amjadmajid/ipRobot/Latex/Thesis/template/frontcover.tex

%%\usepackage[total={210mm,297mm},left=0pt,bottom=0pt,top=0cm,right=0pt,headsep=0pt,head=0pt,showframe]{geometry}

%%\input{preambleL31958}
%%\begin{titlepage}
\begin {textblock*}{210mm}(0mm,0mm)
\noindent

\sffamily
\vspace{.8cm}
\begin{center}
\Large
Delft University of Technology\\
Master's Thesis in \reportMSC\\
\vspace{2cm}
\parbox{170mm}{\bfseries\centering\Huge\reportTitle}\\
\vspace{1cm}
\parbox{170mm}{\bfseries\centering\reportAuthor}

\end{center}
\end{textblock*}

\begin {textblock*}{210mm}[0.0,1.0](0mm,297mm)
\noindent

\hfill\parbox{15.5cm}{

}
\vspace*{4cm}

\noindent
\hspace{1.89cm}
\hfill\parbox{5cm}{
}
\hspace*{2cm}\\

\vspace*{1.5cm}
\noindent

\end{textblock*}

\null\newpage
