amjadmajid/ipRobot/Latex/Thesis/chapters/appendix_a.tex

\chapter{Schematic of the Robot PCB}
\label{app:schematic_robot}

\begin{figure}[h!]
	\centering
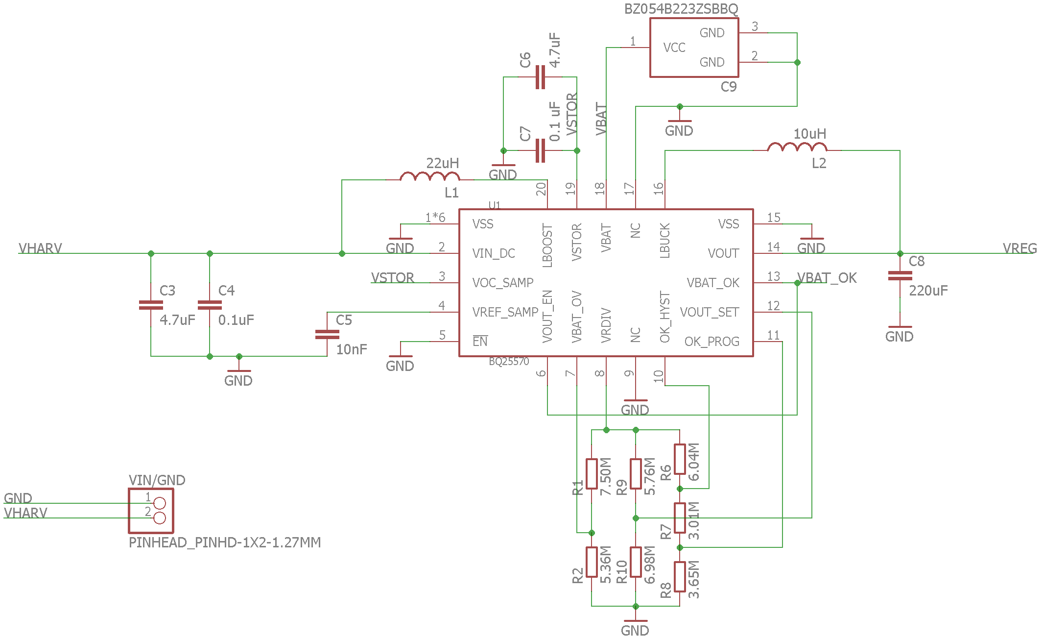
[picture p11: Latex/Thesis/pics/pcb_harvester_schematic.png]
	
	\caption{Energy harvester part of the schematic}
	\label{fig:pcb_harvester_schematic}
\end{figure}

\begin{figure}[h!]
	\centering
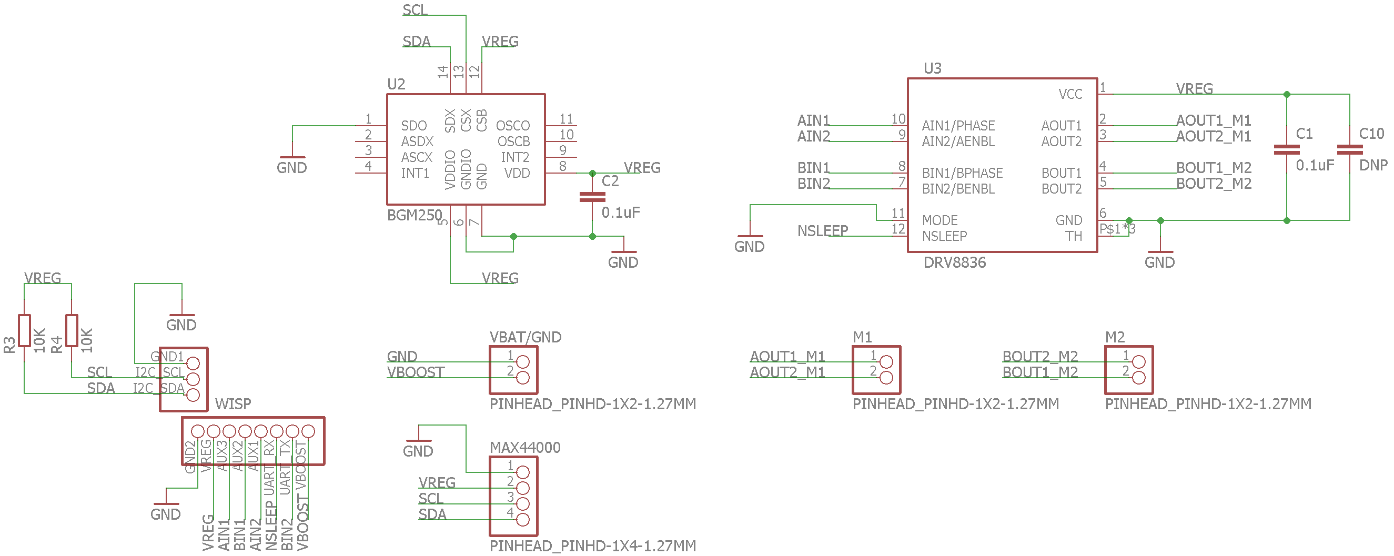
[picture p12: Latex/Thesis/pics/pcb_sens_ctrl_schematic.png]
	
	\caption{Sensing and control part of the schematic}
	\label{fig:pcb_sens_ctrl_schematic}
\end{figure}
