amjadmajid/ipRobot/Latex/Thesis/template/titlepage.tex

\begin{titlepage}

  \begin{center}
  \null\vfill
    \begin{center}
    \LARGE{\reportTitle}
    \end{center}

    \vspace{3cm}

    \begin{large}
    Master's Thesis in \reportMSC
    \end{large}

    \vspace{1.5cm}

    \begin{normalsize}
    Embedded Software Section\\
    Faculty of Electrical Engineering, Mathematics and Computer Science\\
    Delft University of Technology\\
    Mekelweg 4, 2628 CD Delft, The Netherlands
    \end{normalsize}

    \vspace{2.0cm}

    \begin{normalsize}
    \reportAuthor \\
    \reportUrlEmail
    \end{normalsize}

    \vspace{1.0cm}

    % <MM> DD, YYYY
    \reportDate             %TODO: Dit is de datum van uitgifte van final versie aan de afstudeer commissie

  \vfill
  \end{center}

\end{titlepage}
