amjadmajid/ipRobot/Latex/Paper/Ideas-references.txt

Interminttent communication:
https://arxiv.org/pdf/1312.1421v1.pdf

Solar harvesting toy: Solarbotics SolarSpeeder v2.0
https://solarbotics.com/product/k_ss/

Self-driving potato
https://www.youtube.com/watch?v=oNjPHcIzQkM

Braitenberg vehicle

Robotic wireless sensor networks:
https://arxiv.org/pdf/1705.05415.pdf

Intermittend control: 
https://arxiv.org/pdf/1705.08228.pdf

Bio degradeable batteries:
http://www.energyharvestingjournal.com/articles/11125/metal-free-biotically-degradable-battery-for-single-use-applications
http://mems.seas.upenn.edu/publications/2014/AMEMSEnabledBiodegradableBatteryForPoweringTransientImplantableDevices.pdf 

Addressable wireless actuation for multijoint folding robots and devices
http://robotics.sciencemag.org/content/2/8/eaan1544
http://gizmodo.com/incredible-self-folding-robots-work-without-batteries-o-1797125283

Ultra-low-power Wireless Streaming Cameras
https://arxiv.org/pdf/1707.08718.pdf

1D Printing of Recyclable Robots
http://ieeexplore.ieee.org/stamp/stamp.jsp?arnumber=7950924
http://gizmodo.com/this-printer-doodles-stick-figure-robots-to-explore-are-1796985080

Powering Pervasive Computing Systems (already added to bib)
http://ieeexplore.ieee.org/document/7994569/

Combine swarm operating system (links are examples) with intermittent computation
http://ieeexplore.ieee.org/document/7759558/
http://ieeexplore.ieee.org/document/7759660/
