amjadmajid/ipRobot/Latex/Thesis/thesis.tex

% This document provides the style to be used for a MSc Thesis at the
% Parallel and Distributed Systems group
\documentclass[11pt,twoside,a4paper,openright]{report}

% math packages
\usepackage{amsmath}
\usepackage{amssymb}

% textblocks for title page
\usepackage[absolute]{textpos}

% use babel for proper hyphenation
\usepackage[british]{babel}

% Graphics: different for pdflatex or dvi output, choose one
%%\usepackage[dvips]{graphicx}
\usepackage[pdftex]{graphicx}
\usepackage{graphicx}

\usepackage{epstopdf}
\usepackage{rotating}
\usepackage{subcaption}

% FONT
\usepackage[scaled=.92]{helvet}
%\usepackage{times}
\usepackage{textcomp}
\usepackage{eurosym}

% for url's use "\url{http://www.google.com/}"
\usepackage{url}
\usepackage[plainpages=false]{hyperref} 

% Table
\usepackage{threeparttable, tablefootnote}
\usepackage{tabularx}
\usepackage{multirow}

% References
\usepackage{flushend}

% Tikz
\usepackage{tikz}
\usepackage{circuitikz}

% Information that will be filled in at various points in the report
\newcommand{\reportTitle}{Transiently-powered Battery-free Robot}
\newcommand{\reportAuthor}{Koen Schaper}
\newcommand{\reportEmail}{kpschaper@gmail.com}
\newcommand{\reportUrlEmail}{\href{mailto:\reportEmail}{\reportEmail}}
\newcommand{\reportMSC}{Embedded Systems} %{Embedded Systems}{Computer Engineering}{Computer Science}{Electrical Engineering}
\newcommand{\reportDate}{\today} %TODO: Dit is de datum van uitgifte van final versie aan de afstudeer commissie 
\newcommand{\presentationDate}{15 December 2017}
\newcommand{\graduationCommittee}{
prof. dr. K.G. Langendoen (chair) & Delft University of Technology \\
dr. Przemys\l{}aw Pawe\l{}czak (supervisor) & Delft University of Technology \\
dr. Javier Alonso-Mora & Delft University of Technology \\
} % The order of listing the names: Graduation prof, supervisor(s), others ordered by title + alphabetical 
%examples: 
%prof. dr. ir. H. J. Sips (chair) & Delft University of Technology \\ 
%ir. dr. D. H. J. Epema           & Delft University of Technology \\ 
\newcommand{\reportAbstract}{
	\input{chapters/abstract}
}
\newcommand{\reportKeywords}{TODO KEYWORDS}

% For pdflatex
\pdfinfo{
   /Author (\reportAuthor)
   /Title  (\reportTitle)
   /Keywords (\reportKeywords)
}

\begin{document}

\pagenumbering{alph}
\pagestyle{empty}

% FRONTCOVER
\include{template/frontcover}

%%%%%%%%%%%%%%%%%%%%%%%%%%%%%%%%%%%%%%%%%%%%%%%%%%%%%%%%%%%%%%%%%%%%%%%%%%%%%%%
\hoffset=1.63cm
\oddsidemargin=0in
\evensidemargin=0in
\textwidth=5in

%%%%%%%%%%%%%%%%%%%%%%%%%%%%%%%%%%%%%%%%%%%%%%%%%%%%%%%%%%%%%%%%%%%%%%%%%%%%%%%
\parindent=1em

% EMPTY PAGE
\cleardoublepage

\pagestyle{plain}
\pagenumbering{roman}
\setcounter{page}{1}

% TITLE PAGE: page i (hidden)
\include{template/titlepage}

% GRADUATION DATA AND ABSTRACT: pages ii and iii (hidden)
\include{template/graduationdata}
%\setcounter{page}{4}

% EMPTY PAGE: page iv
\cleardoublepage

% OPTIONAL QUOTATION: page v
%\include{quotation}
% EMPTY PAGE: page vi
%\cleardoublepage

% PREFACE: page v
\include{chapters/preface}
% EMPTY PAGE: page vi
\cleardoublepage

% TABLE OF CONTENTS: starting at page vii
\tableofcontents

\cleardoublepage

\pagenumbering{arabic}
\setcounter{page}{1}

% INTRODUCTION: page 1
\include{chapters/introduction}

% CHAPTERS ... For instance: History/Prior Work, Design/Implementation, Experiments
\include{chapters/related_work}

\include{chapters/preliminaries}

%\input{chapters/model}

\include{chapters/design_and_implementation}

\include{chapters/evaluation}

% CONCLUSIONS AND FUTURE WORK
\include{chapters/summary}

% BIBLIOGRAPHY
%#define SORTED 1
%\bibliographystyle{../bib/latex8}
%\bibliography{../bib/bibtex}

\bibliographystyle{IEEEtran}
\bibliography{IEEEabrv,bib/bibtex,bib/non-paper}

\appendix
\include{chapters/appendix_a}

\end{document}
