amjadmajid/ipRobot/Latex/Presentation/pics/foto base/sony_toio.jpg

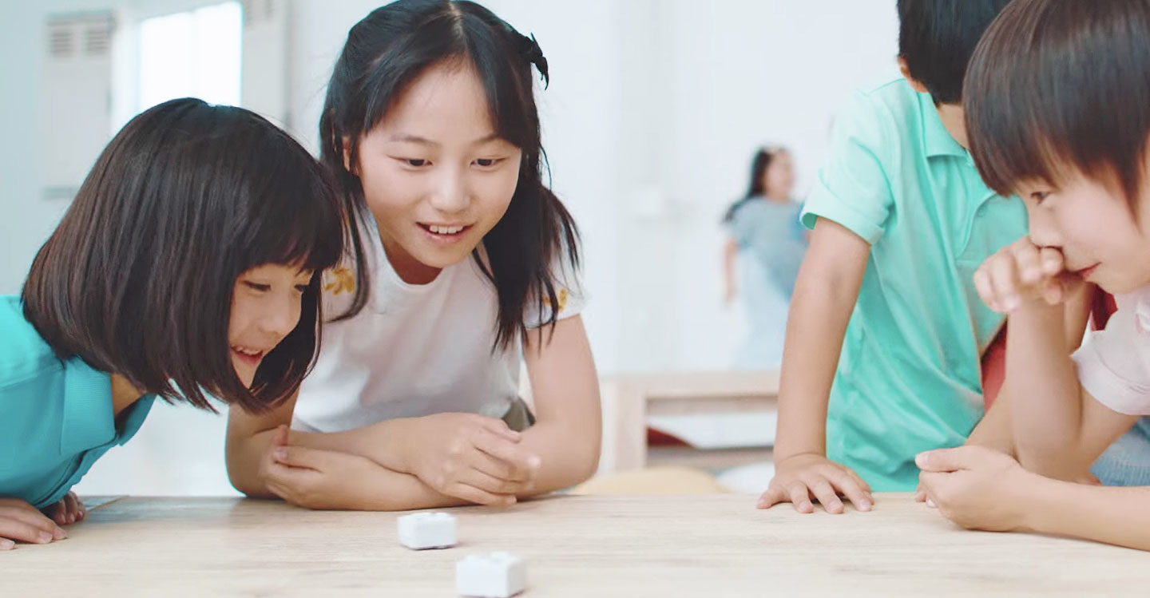
Latex/Presentation/pics/foto base/sony_toio.jpg
