amjadmajid/ipRobot/Latex/Thesis/pics/bipolar_stepper.png

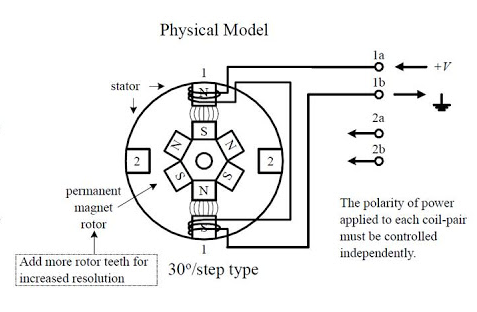
Latex/Thesis/pics/bipolar_stepper.png
