amjadmajid/ipRobot/Latex/Thesis/data/cost_of_parts.xlsx

Sheet: Dollar to euro
Description: | Part name: | Quantity: | cost (dollar): | total cost (dollar): | Cost for 20 (dollar): | Total cost (dollar): | From:
Motors | 26:1 Sub-Micro Plastic Planetary Gearmotor 6Dx16L mm | 2 | 11.95 | 23.9 | 10.76 | 21.52 | Pololu | 18.5072
Wheels | 14×4.5mm Wheel Pair for Sub-Micro Plastic Planetary Gearmotors | 1 | 1.95 | 1.95 | 1.79 | 1.79 | Pololu | 1.5394
Caster | Ball Caster with 1/2″ Plastic Ball | 1 | 1.99 | 1.99 | 1.79 | 1.79 | Pololu | 1.5394
Harvester | BQ25570 | 1 | 7.06 | 7.06 | 6.37 | 6.37 | Digikey | 5.4782
Gyroscope | BMG250 | 1 | 4.19 | 4.19 | 3.27 | 3.27 | Digikey | 2.8122
H-bridge | TI DRV8836 | 1 | 1.91 | 1.91 | 1.72 | 1.72 | Digikey | 1.4792
Supercap | BZ054B223ZSB | 1 | 9.16 | 9.16 | 8.64 | 8.64 | Mouser | 7.4304
PCB | IPR board v2.0 | 1 | 2.166666667 | 2.166666667 | 2.166666667 | 2.166666667 | Osh Park | 1.863333333
Solar panel | SLMD121H04L | 2 | 6.2 | 12.4 | 5.58 | 11.16 | Digikey | 9.5976
Small components | Small components | 1 | 4.406 | 4.406 | 4.406 | 4.406 | Farnell | 3.78916
 |  |  |  | 69.13266667 |  | 62.83266667 |  | 54.03609333
 |  |  |  |  | Euro price: | 54.03609333
Extra sensor:
Proximity sensor | MAX44000 | 1 | 4.22 | 4.22 | 3.98 | 3.98 | Digikey
IR led for proximity | SFH 4651-Z | 1 | 1.11 | 1.11 | 0.86 | 0.86 | Mouser
PCB | Proximity board | 1 | 0.3333333333 | 0.3333333333 | 0.3333333333 | 0.3333333333 | Osh Park
 |  |  |  | 5.663333333 |  | 5.173333333
 |  |  |  |  | Euro price: | 4.5008
 |  |  |  |  | TOTAL EURO PRICE | 58.53689333

Sheet: Euro suppliers
Description: | Part name: | Quantity: | cost: | total cost: | Cost for 20 | Total cost: | From:
Motors | 26:1 Sub-Micro Plastic Planetary Gearmotor 6Dx16L mm | 2 | 10.04 | 20.08 | 9.41 | 18.82 | Tme.eu
Wheels | 14×4.5mm Wheel Pair for Sub-Micro Plastic Planetary Gearmotors | 1 | 2.02 | 2.02 | 1.89 | 1.89 | Tme.eu
Caster | Ball Caster with 1/2″ Plastic Ball | 1 | 1.95 | 1.95 | 1.83 | 1.83 | Tme.eu
Harvester | BQ25570 | 1 | 10.29113924 | 10.29113924 | 5.93 | 5.93 | Farnell
Gyroscope | BMG250 | 1 | 3.848101266 | 3.848101266 | 2.54 | 2.54 | Mouser
H-bridge | TI DRV8836 | 1 | 2.506329114 | 2.506329114 | 1.62 | 1.62 | Farnell
Supercap | BZ054B223ZSB | 1 | 9.82278481 | 9.82278481 | 9.265822785 | 9.265822785 | Mouser
PCB | IPR board v2.0 | 1 | 1.966666667 | 1.966666667 | 1.966666667 | 1.966666667 | Osh Park
Solar panel | SLMD121H04L | 2 | 5.23 | 10.46 | 7.058227848 | 14.1164557 | Digikey
Small components |  | 1 | 4.406 | 4.406 | 4.406 | 4.406 | Farnell
 |  |  |  | 67.3510211 |  | 62.38494515
Extra sensor:
Proximity sensor | MAX44000 | 1 | 4.544303797 | 4.544303797 | 2.54 | 2.54 | Mouser
IR led for proximity | SFH 4651-Z | 1 | 0.85 | 0.85 | 0.66 | 0.85 | Mouser
PCB | Proximity board | 1 | 0.25 | 0.25 | 0.25 | 0.25 | Osh Park
