amjadmajid/ipRobot/Latex/Thesis/pics/step_counting.jpg

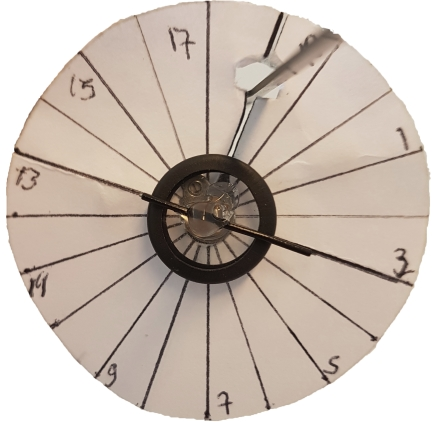
Latex/Thesis/pics/step_counting.jpg
