amjadmajid/ipRobot/Code/Python/Video experiments/PWM_SPEED_RELATION.xlsx

Sheet: Blad1
 |  | Int every 1.25 sec: |  | Int every 1 sec: |  | Int every 0.75 sec |  | Int every 0.5 sec:
 |  | Dist: 143/(145-15) |  | Dist: 143/(142-15) |  | Dist: 143/(135-15) |  | Dist: 143 / (127-15) |  | P control r turn = 0.12
PWM: 70 | Run time: | 5.5 |  | 5.62992126 |  | 5.958333333 |  | 6.383928571
Distance: 150cm max | 5 | 5.5 |  | 5.6 |  | 6 |  | 6.4
141.9 | 28.38 | 144.1 | 26.2 | 141.8 | 25.32142857 | 147.2 | 24.53333333 | 143.5 | 22.421875
146.2 | 29.24 | 145.1 | 26.38181818 | 144.8 | 25.85714286 | 147.3 | 24.55 | 145.1 | 22.671875
144.6 | 28.92 | 144.3 | 26.23636364 | 145.4 | 25.96428571 | 148.1 | 24.68333333 | 147.3 | 23.015625
143.2 | 28.64 | 145.6 | 26.47272727 | 145.3 | 25.94642857 | 146.6 | 24.43333333 | 146.8 | 22.9375
143.1 | 28.62 | 145.9 | 26.52727273 | 143.6 | 25.64285714 | 147.2 | 24.53333333 | 145.2 | 22.6875
 | 28.76 | Avg Speed: | 26.36363636 | Avg Speed: | 25.74642857 | Avg Speed: | 24.54666667 | Avg Speed: | 22.746875
 |  | Int every 1.25 sec: |  | Int every 1 sec: |  | Int every 0.75 sec |  | Int every 0.5 sec:
 |  | Dist: 143/(148-15) |  | Dist: 143/(144-15) |  | Dist: 143/(139-15) |  | Dist: 143 / (129-15)
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
