amjadmajid/ipRobot/Code/Python/Experiments/Light_experiment_11-10_and_23-11.xlsx

Sheet: Chineese panel 50x50
Lamp 60 W halogeen
Distance (cm) | 1 | 2 | 3
50 | 26.04 | 26.71 | 26.08 | 26.27666667 | Light Intensity (Lux) | Temperature
30 | 6.489 | 6.389 | 6.481 | 6.453 | 577 | 22/23
10 | 3.034 | 3.093 | 3.124 | 3.083666667 | 2460 | 23
1 | 1.332 | 1.357 | 1.356 | 1.348333333 | 5790 | 25
 |  |  |  |  | 9550 | 42
Lamp 120 W halogeen
Distance (cm) | 1 | 2 | 3
50 | 17.09 | 18.051 | 17.64 | 17.59366667
30 | 6.703 | 6.766 | 6.694 | 6.721 | 1179 | 23
10 | 1.156 | 2.716 | 2.706 | 2.192666667 | 2496 | 25
 |  |  |  |  | 8760 | 35
Lamp 150W White
Distance (cm) | 1 | 2 | 3
50 | 17.72 | 17.87 | 18.15 | 17.91333333 | Light Intensity (Lux)
30 | 7.846 | 7.795 | 7.843 | 7.828 | 1027 | 26
10 | 1.002 | 0.9503 | 1.029 | 0.9937666667 | 2046 | 25
 |  |  |  |  | 9860 | 37
Lamp 150W Red
Distance (cm) | 1 | 2 | 3
50 | 9.276 | 9.615 | 9.496 | 9.462333333
30 | 1.79 | 1.803 | 2.048 | 1.880333333 | 821 | 31
10 | 0.7548 | 0.7074 | 0.74 | 0.7340666667 | 2652 | 37
 |  |  |  |  | 10550 | 66
Current temp: no light | 22
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
