amjadmajid/ipRobot/Code/Python/Video experiments/settings_deviation_from_straight.xlsx

Sheet: Blad1
30 | avg mean | avg std | max
0 | 0.36 | 0.16 | 0.86
1.25 | 0.34 | 0.12 | 0.67
1 | 0.56 | 0.27 | 1.35
0.75 | 0.6 | 0.27 | 1.04
0.5 | 0.44 | 0.22 | 0.86
Solar | 0.5 | 0.25 | 1.35
50 | avg mean | avg std | max
0 | 0.25 | 0.12 | 0.52
1.25 | 0.31 | 0.14 | 0.72
1 | 0.44 | 0.21 | 0.91
0.75 | 0.8 | 0.35 | 1.44
0.5 | 1.17 | 0.54 | 2.15
Solar | 0.41 | 0.17 | 1.05
70 | avg mean | avg std | max
0 | 0.28 | 0.13 | 0.54
1.25 | 0.42 | 0.17 | 0.9
1 | 0.95 | 0.42 | 1.76
0.75 | 0.88 | 0.37 | 1.88
0.5 | 1.09 | 0.61 | 2.18
Solar | 0.3 | 0.15 | 0.69

Sheet: Length movement
30 | avg mean | avg std | max
0 | 81.6 | 0.17 | 81.78
1.25 | 80.09 | 0.095 | 80.18
1 | 76.41 | 0.22 | 76.63
0.75 | 76.65 | 0.47 | 77.12
0.5 | 76.86 | 1.21 | 78.08
Solar | 80.72 | 0.49 | 81.16
50 | avg mean | avg std | max
0 | 79.62 | 0.47 | 80.09
1.25 | 79.91 | 0.34 | 80.26
1 | 80.35 | 0.17
0.75 | 77.95 | 0.153 | 78.1
0.5 | 79.2 | 0.22 | 79.2
Solar | 80.22 | 1.05 | 81.7
70 | avg mean | avg std | max
0 | 73.72 | 0 | 73.72
1.25 | 73.44 | 0.4 | 73.82
1 | 73.21 | 0.15 | 73.37
0.75 | 74.04 | 0.57 | 74.61
0.5 | 71.3 | 0.02 | 71.35
Solar | 81.4 | 0.38 | 81.92
