amjadmajid/ipRobot/Code/Python/Video experiments/settings_deviation_from_circle.xlsx

30 | R | xoff | yoff | avg mean | avg std | max
0 | 34 | 0 | -7 | 1.3 | 0.67 | 4.3
1.25 | 32 | 0 | -5 | 1.29 | 0.69 | 2.59
1 | 32 | 0 | -3 | 1.52 | 0.81 | 3.95
0.75 | 33 | 0 | -5 | 1.21 | 0.82 | 4.07
0.5 | 32 | 0 | -3 | 1.85 | 1.3 | 6.08
Solar | 32 | -1 | -4 | 0.89 | 0.46 | 1.93
50 | R | xoff | yoff | avg mean | avg std | max
0 | 34 | -1 | -7 | 1.2 | 0.67 | 3.03
1.25 | 32 | 0 | -2 | 1.01 | 0.57 | 2.64
1 | 33 | 0 | -4 | 1.42 | 0.92 | 4.2
0.75 | 33 | 0 | -4 | 1.11 | 0.73 | 2.89
0.5 | 33 | 0 | -4 | 0.79 | 0.37 | 1.86
Solar | 31 | -1 | -3 | 0.88 | 0.4 | 1.91
70 | R | xoff | yoff | avg mean | avg std | max
0 | 30 | 0 | -3 | 0.9 | 0.45 | 2.37
1.25 | 31 | 0 | -2 | 0.81 | 0.43 | 2.99
1 | 31 | 0 | -2 | 1.06 | 0.65 | 3.5
0.75 | 31 | 0 | -1 | 0.71 | 0.41 | 2.12
0.5 | 32 | 0 | -4 | 1.69 | 1.23 | 4.53
Solar | 31 | -1 | -3 | 0.88 | 0.37 | 2.1
