amjadmajid/ipRobot/Code/Python/Experiments/RF_experiment_23-11.xlsx

Distance | T1 | T2 | T3 | T4 | T5
20 | 42.27 | 41.8 | 41.51 | 42.09 | 42.03 | 41.94
25 | 47.82 | 48.41 | 51.07 | 48.72 | 49.48 | 49.1
30 | 103.9 | 108 | 99.49 | 100.3 | 94.81 | 101.3
35 | 61.08 | 61.56 | 61.09 | 60.86 | 60.76 | 61.07
45 | 163 | 177.77 | 176.4 | 158.4 | 148.5 | 164.814
50 | 203.7 | 204.5 | 175 |  | 154.9 | 184.525
