amjadmajid/ipRobot/Code/Python/Experiments/Min_speed_experiment_12-10.xlsx

Target = 20 | 1 | 2 | 3 |  | Speed
7sec | 129.5 | 124.6 | 127.9 | 127.3333333 | 18.19047619
200 | 197.3 | 199.1 | 196.4 | 197.6
150 | 150.3 | 153.5 | 147.1 | 150.3
100 | 98.9 | 98.4 | 99.6 | 98.96666667
50 | 48.4 | 48.2 | 47.5 | 48.03333333
Target = 30 | 1 | 2 | 3 | Average | Speed
7sec | 151.7 | 150.7 | 151.6 | 151.3333333 | 21.61904762
200 | 197.9 | 197.5 | 199.3 | 198.2333333
150 | 150 | 149.8 | 148.1 | 149.3
100 | 98.4 | 97.8 | 98.7 | 98.3
50 | 47.6 | 46.8 | 47.8 | 47.4
Target = 40 | 1 | 2 | 3 | Average | Speed
7sec | 168.8 | 171.8 | 170.6 | 170.4 | 24.34285714
200 | 199.4 | 199.8 | 199.7 | 199.6333333
150 | 149.8 | 147.2 | 148.4 | 148.4666667
100 | 97.8 | 99.5 | 97.4 | 98.23333333
50 | 46.9 | 47 | 46.8 | 46.9
25 | 20.7 | 20.6 | 20.7 | 20.66666667
Target = 50 | 1 | 2 | 3 | Average | Speed
7sec | 185.2 | 186.4 | 184.3 | 185.3 | 26.47142857
200 | 198.9 | 199.1 | 201.6 | 199.8666667
150 | 145.1 | 146.8 | 146.8 | 146.2333333
100 | 96.3 | 96.7 | 97.4 | 96.8
50 | 47.1 | 46 | 46.5 | 46.53333333
Target = 60 | 1 | 2 | 3 | Average | Speed
7sec | 198.6 | 200.1 | 199.9 | 199.5333333 | 28.5047619
200 | 197 | 197.8 | 198.1 | 197.6333333
150 | 146.4 | 145.9 | 144.9 | 145.7333333
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
