amjadmajid/ipRobot/Code/Python/Motor calibration/data_19-10/r1_max_freq_1.csv

Time (s) | Main Avg Current (mA) | Main Avg Voltage (V) | Main Max Current (mA)
4.1316 | 1.636 | 2.198 | 1.636
4.1318 | 1.67 | 2.198 | 1.67
4.1320 | 1.67 | 2.1975 | 1.67
4.1322 | 1.7 | 2.198 | 1.7
4.1324 | 1.656 | 2.198 | 1.7
4.1326 | 1.5 | 2.197 | 1.7
4.1328 | 1.754 | 2.198 | 1.754
4.1330 | 1.636 | 2.1975 | 1.754
4.1332 | 1.558 | 2.198 | 1.754
4.1334 | 1.706 | 2.1975 | 1.754
4.1336 | 1.656 | 2.1975 | 1.754
4.1338 | 1.724 | 2.1975 | 1.754
4.1340 | 1.632 | 2.198 | 1.754
4.1342 | 1.658 | 2.1975 | 1.754
4.1344 | 1.522 | 2.1975 | 1.754
4.1346 | 1.748 | 2.1975 | 1.754
4.1348 | 1.632 | 2.1975 | 1.754
4.1350 | 1.744 | 2.1975 | 1.754
4.1352 | 1.568 | 2.1975 | 1.754
4.1354 | 1.778 | 2.1975 | 1.778
4.1356 | 1.634 | 2.198 | 1.778
4.1358 | 1.586 | 2.197 | 1.778
4.1360 | 1.694 | 2.1975 | 1.778
4.1362 | 1.612 | 2.1975 | 1.778
4.1364 | 1.602 | 2.1975 | 1.778
4.1366 | 1.806 | 2.1975 | 1.806
4.1368 | 1.522 | 2.198 | 1.806
4.1370 | 1.74 | 2.198 | 1.806
4.1372 | 1.666 | 2.1975 | 1.806
4.1374 | 1.498 | 2.1975 | 1.806
4.1376 | 1.688 | 2.198 | 1.806
4.1378 | 1.8 | 2.198 | 1.806
4.1380 | 1.522 | 2.1975 | 1.806
4.1382 | 1.64 | 2.1975 | 1.806
4.1384 | 1.666 | 2.1975 | 1.806
4.1386 | 1.618 | 2.1975 | 1.806
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
