amjadmajid/ipRobot/Code/Python/Motor calibration/data_19-10/r1_max_freq_120.csv

Time (s) | Main Avg Current (mA) | Main Avg Voltage (V) | Main Max Current (mA)
4.0654 | 1.71 | 2.1975 | 1.71
4.0656 | 1.664 | 2.197 | 1.71
4.0658 | 1.834 | 2.197 | 1.834
4.0660 | 1.604 | 2.197 | 1.834
4.0662 | 1.78 | 2.197 | 1.834
4.0664 | 1.678 | 2.197 | 1.834
4.0666 | 1.632 | 2.1975 | 1.834
4.0668 | 1.822 | 2.1975 | 1.834
4.0670 | 1.622 | 2.1975 | 1.834
4.0672 | 1.68 | 2.197 | 1.834
4.0674 | 1.782 | 2.197 | 1.834
4.0676 | 1.602 | 2.197 | 1.834
4.0678 | 1.69 | 2.1975 | 1.834
4.0680 | 1.8 | 2.197 | 1.834
4.0682 | 1.502 | 2.197 | 1.834
4.0684 | 1.92 | 2.197 | 1.92
4.0686 | 1.686 | 2.1975 | 1.92
4.0688 | 1.596 | 2.1975 | 1.92
4.0690 | 1.684 | 2.197 | 1.92
4.0692 | 1.6 | 2.1975 | 1.92
4.0694 | 1.834 | 2.1975 | 1.92
4.0696 | 1.74 | 2.197 | 1.92
4.0698 | 1.678 | 2.1975 | 1.92
4.0700 | 1.678 | 2.197 | 1.92
4.0702 | 1.744 | 2.1975 | 1.92
4.0704 | 1.6 | 2.197 | 1.92
4.0706 | 1.77 | 2.1975 | 1.92
4.0708 | 1.624 | 2.1975 | 1.92
4.0710 | 1.76 | 2.197 | 1.92
4.0712 | 1.736 | 2.1975 | 1.92
4.0714 | 1.574 | 2.197 | 1.92
4.0716 | 1.812 | 2.197 | 1.92
4.0718 | 1.602 | 2.1975 | 1.92
4.0720 | 1.792 | 2.197 | 1.92
4.0722 | 1.758 | 2.197 | 1.92
4.0724 | 1.604 | 2.1975 | 1.92
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
