amjadmajid/ipRobot/Code/Python/Motor calibration/data_19-10/r1_max_freq_140.csv

Time (s) | Main Avg Current (mA) | Main Avg Voltage (V) | Main Max Current (mA)
4.1598 | 1.534 | 2.197 | 1.534
4.1600 | 1.646 | 2.197 | 1.646
4.1602 | 1.562 | 2.197 | 1.646
4.1604 | 1.78 | 2.197 | 1.78
4.1606 | 1.622 | 2.1975 | 1.78
4.1608 | 1.622 | 2.1975 | 1.78
4.1610 | 1.72 | 2.1975 | 1.78
4.1612 | 1.578 | 2.197 | 1.78
4.1614 | 1.682 | 2.197 | 1.78
4.1616 | 1.756 | 2.1975 | 1.78
4.1618 | 1.624 | 2.1975 | 1.78
4.1620 | 1.598 | 2.197 | 1.78
4.1622 | 1.636 | 2.197 | 1.78
4.1624 | 1.69 | 2.197 | 1.78
4.1626 | 1.614 | 2.197 | 1.78
4.1628 | 1.658 | 2.197 | 1.78
4.1630 | 1.602 | 2.1975 | 1.78
4.1632 | 1.636 | 2.197 | 1.78
4.1634 | 1.614 | 2.197 | 1.78
4.1636 | 1.708 | 2.197 | 1.78
4.1638 | 1.704 | 2.1975 | 1.78
4.1640 | 1.632 | 2.197 | 1.78
4.1642 | 1.58 | 2.197 | 1.78
4.1644 | 1.746 | 2.197 | 1.78
4.1646 | 1.648 | 2.197 | 1.78
4.1648 | 1.658 | 2.1975 | 1.78
4.1650 | 1.676 | 2.1975 | 1.78
4.1652 | 1.688 | 2.197 | 1.78
4.1654 | 1.462 | 2.197 | 1.78
4.1656 | 1.788 | 2.197 | 1.788
4.1658 | 1.814 | 2.197 | 1.814
4.1660 | 1.534 | 2.1975 | 1.814
4.1662 | 1.578 | 2.197 | 1.814
4.1664 | 1.722 | 2.1975 | 1.814
4.1666 | 1.682 | 2.1975 | 1.814
4.1668 | 1.55 | 2.197 | 1.814
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
