amjadmajid/ipRobot/Code/Python/Motor calibration/data_19-10/r1_max_freq_25.csv

Time (s) | Main Avg Current (mA) | Main Avg Voltage (V) | Main Max Current (mA)
2.7146 | 1.636 | 2.1975 | 1.636
2.7148 | 1.746 | 2.197 | 1.746
2.7150 | 1.57 | 2.1975 | 1.746
2.7152 | 1.65 | 2.1975 | 1.746
2.7154 | 1.756 | 2.1975 | 1.756
2.7156 | 1.63 | 2.1975 | 1.756
2.7158 | 1.636 | 2.1975 | 1.756
2.7160 | 1.582 | 2.1975 | 1.756
2.7162 | 1.756 | 2.1975 | 1.756
2.7164 | 1.596 | 2.1975 | 1.756
2.7166 | 1.702 | 2.1975 | 1.756
2.7168 | 1.582 | 2.198 | 1.756
2.7170 | 1.728 | 2.198 | 1.756
2.7172 | 1.566 | 2.1975 | 1.756
2.7174 | 1.756 | 2.1975 | 1.756
2.7176 | 1.638 | 2.198 | 1.756
2.7178 | 1.672 | 2.1975 | 1.756
2.7180 | 1.576 | 2.197 | 1.756
2.7182 | 1.786 | 2.1975 | 1.786
2.7184 | 1.532 | 2.198 | 1.786
2.7186 | 1.71 | 2.1975 | 1.786
2.7188 | 1.578 | 2.1975 | 1.786
2.7190 | 1.718 | 2.1975 | 1.786
2.7192 | 1.652 | 2.1975 | 1.786
2.7194 | 1.734 | 2.198 | 1.786
2.7196 | 1.59 | 2.1975 | 1.786
2.7198 | 1.766 | 2.1975 | 1.786
2.7200 | 1.546 | 2.198 | 1.786
2.7202 | 1.756 | 2.1975 | 1.786
2.7204 | 1.424 | 2.1975 | 1.786
2.7206 | 1.802 | 2.198 | 1.802
2.7208 | 1.59 | 2.1975 | 1.802
2.7210 | 1.696 | 2.198 | 1.802
2.7212 | 1.75 | 2.1975 | 1.802
2.7214 | 1.582 | 2.1975 | 1.802
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
