amjadmajid/ipRobot/Latex/Paper/Revisions/Introduction 22 December 2016 Revised P Pawelczak 22 December 2016 (1).pdf

## A Intermittently Powered Battery-Free Robot

By: Koen Schaper (4078306) December 22, 2016

## 1 Introduction

Wireless Sensor Networks (WSN) are commonly used measure verity of different environmental conditions. The conditions measured can range from temperature, light humidity, to more complex sensing which requires additional computation. Fully programmable platforms have been developed to exploring the combination of sensing and computation, while operating battery-less by making use of energy harvesting [1]. The energy collected from RF signals is very minimal and decreases with the distance of the device to the source. RF energy can be rather intermittent in terms of availability, it requires the source to transmit. Other sources available for exploration are often limited by the application. Secondly most sources can be scarce or completely absent during prolonged time intervals of the day as well [2].
To allow more complex sensing, the energy budged needs to be evaluated carefully. Harvesting more energy increases the charge time but also increases the operation time. Most applications are not programmed to operate intermittently and therefore require enough energy to finish a single sensing operation. To store the energy an appropriate size storage capacitor needs to be selected [3]. A way to reduce the required energy is to communicate without active radios, but instead use an existing electromagnetic wave produced by a remote emitter. Backscatter communication uses the wave and creates a signal by modulating the impedance of the antenna, causing a change in the amount of energy reflected back to the emitter [1, 2, 3]. Even though WSN make it possible to cover big areas for sensing they are physically bound to a fixed location. Which in turn makes them ”static” and require human intervention to make them cover new areas or change their location.
On the other hand, low cost robotic platforms have been developed to tackle a variety of challenges anonymously. Miniature robots can be used for inspection in difficult to reach places, operating like mobile sensing units. Hardware modularity is a way to make the robot adapt its resources to different environments and sensing operations. By separating out power, computation, motor control and sensing a verity of capabilities can be tested [5, 4]. Microrobots typically use infrared-based neighbor to neighbor distance sensing and communication [6]. While controlling a swarm or collective is mainly accomplished by means of active low power transceivers [5, 4]. Choosing the right locomotion resource can depend on different factors, moving in the most energy efficient way on a particular surface is often the determining factor. On a flat surface, robots commonly use a two-wheeled differential drive design to not only move but allow for steering as well [4, 5]. In other designs overall cost is a decisive factor, Kilobot uses two vibrating motors for locomotion. When the motors are activated the centripetal forces will generate a forward movement [6]. The GRITSBot does not use conventional dc motors, requiring encoders to estimate their speed. Instead by using stepper motors the speed can be set by changing the delay between steps. Estimating it’s position therefore is reduced to simply counting steps [4].
Unlike WSN, robots still rely on batteries as a source of power, since electric motors consume considerably more energy compared to computation and sensing. Lithium-ion batteries have a high energy density but still limit the operation time of the robot. When the voltage of the battery drops below a certain level, indicating that the battery is almost empty, the robot needs to move to a charging station before it runs out of energy. Replacement of the battery with a energy harvesting system would make the robot energy-autonomous. This research will explore the feasibility of a battery-less robot, taking into account the intermittently powered nature of it. Intermittently powering robots creates new challenges in control, navigation and collaboration.

## References

[1] A. P. Sample, D. J. Yeager, P. S. Powledge,
A. V. Mamishev, and J. R. Smith, “Design of an rfid-based battery-free programmable sensing platform,” IEEE Transactions on Instrumentation and Measurement, vol. 57, no. 11, pp. 2608–2615, 2008.
[2] C. | Konstantopoulos, | E. | Koutroulis,
N. Mitianoudis, and A. Bletsas, “Converting a plant to a battery and wireless sensor
with | scatter | radio | and | ultra-low | cost,”
IEEE Transactions on Instrumentation and Measurement, vol. 65, no. 2, pp. 388–398, 2016.

1

[3] S. Naderiparizi, A. N. Parks, Z. Kapetanovic,
B. Ransford, and J. R. Smith, “Wispcam: A battery-free rfid camera,” in 2015 IEEE International Conference on RFID (RFID), pp. 166–173, Year in Conference.
[4] D. Pickem, M. Lee, and M. Egerstedt, “The gritsbot in its natural habitat - a multi-robot
testbed,” | in | 2015 | IEEE | International
Conference | on | Robotics | and Automation
(ICRA), pp. 4062–4067, Year in Conference.
[5] A. P. Sabelhaus, D. Mirsky, L. M. Hill,
N. C. Martins, and S. Bergbreiter, “Tinyterp: A tiny terrestrial robotic platform with modular sensing,” in 2013 IEEE International Conference on Robotics and Automation, pp. 2600–2605, Year in Conference.
[6] M. Rubenstein, C. Ahler, and R. Nagpal, “Kilobot: A low cost scalable robot system for collective behaviors,” in Robotics and Automation (ICRA), 2012 IEEE International
Conference on, | pp. 3293–3298, | Year in
Conference.

2
