amjadmajid/ipRobot/Latex/Paper/Revisions/Introduction 31 March 2017 Revised P Pawelczak 1 April 2017.pdf

## A Intermittently Powered Battery-Free Robot

March 31, 2017

## 1 Introduction

Low cost robotic platforms have been developed to tackle a variety of challenges anonymously. Miniature robots can be used for inspection in difficult to reach places, operating like mobile sensing units. Hardware modularity is a way to make the robot adapt its resources to different environments and sensing operations. By separating out power, computation, motor control and sensing a verity of capabilities can be tested [1, 2]. Microrobots typically use infrared-based neighbor to neighbor distance sensing and communication [3]. While controlling a swarm or collective is mainly accomplished by means of active low power transceivers [1, 2]. Choosing the right locomotion resource can depend on different factors, moving in the most energy efficient way on a particular surface is often the determining factor. On a flat surface, robots commonly use a two-wheeled differential drive design to not only move but allow for steering as well [1, 2]. In other designs overall cost is a decisive factor, Kilobot uses two vibrating motors for locomotion. When the motors are activated the centripetal forces will generate a forward movement [3]. The GRITSBot does not use conventional DC motors, requiring encoders to estimate their speed. Instead by using stepper motors the speed can be set by changing the delay between steps. Estimating it’s position therefore is reduced to simply counting steps [2].
The robotic community has a long lasting
interest | in | persistent | autonomous | solutions.
Advancement in technology provides more efficient components, but mainly reduce the energy conversion efficiency and the energy required for computation. While generally the biggest energy consumers are electric motors, required for locomotion. The operation time is limited by the energy capacity of the robot’s battery.
Typically the operation time is extended by regularly checking the remaining energy in the battery and move to a recharging station before the robot runs out of energy [2, 3]. As an alternative to quickly recharging, the battery can also be swapped automatically when the robot moves into the docking station [4]. Another work shows a robot that is able to swap it’s primary battery using a six degree-of-freedom manipulator, used to grab the dead battery and plug it into a wireless recharging charging station [5]. In these cases the robot is highly reliant on there docking stations to allow for continuous autonomous operation. This can be problematic if the robot is not able to reach it’s station before running out of energy.
Other work researches persistent operation by harvesting renewable energy, particularly solar energy to complement to the robots internal energy source. To capture the optimal amount of solar energy along the way, a map of the expected solar power can be used to compute the optimal path. To distinguish sunny or shaded two methods are proposed in [6], one being a simple datadriven Gaussian Process and the other estimates the geometry of the environment as a latent variable. Energy aware path planning is commonly used in combination with mission planning. In [7], an analysis of the solar radiation is used to generate a time-optimized motion plan and power schedule using a cascaded particle swarm optimization algorithm.
All the previous work assumes that a operation is only possible when there is sufficient energy to complete a task. This research will explore the feasibility of a battery-less robot, allowing persistent operation while having a very small and intermittent source of energy. Intermittently powering robots creates new challenges in control, navigation and collaboration.

## References

[1] A. P. Sabelhaus, D. Mirsky, L. M. Hill,
N. C. Martins, and S. Bergbreiter, “Tinyterp: A tiny terrestrial robotic platform with modular sensing,” in 2013 IEEE International Conference on Robotics and Automation, Year in Conference, Conference Proceedings, pp. 2600–2605.
[2] D. Pickem, M. Lee, and M. Egerstedt, “The gritsbot in its natural habitat - a multi-robot
testbed,” | in | 2015 | IEEE | International
Conference | on | Robotics | and Automation
(ICRA), Year in Conference, | Conference
Proceedings, pp. 4062–4067.
[3] M. Rubenstein, C. Ahler, and R. Nagpal, “Kilobot: A low cost scalable robot system for collective behaviors,” in Robotics and Automation (ICRA), 2012 IEEE International Conference on, Year in Conference, Conference Proceedings, pp. 3293–3298.

1

[4] N. K. Ure, | G. Chowdhary, | T. Toksoz,
J. P. How, M. A. Vavrina, and J. Vian, “An automated battery management system to enable persistent missions with multiple aerial vehicles,” IEEE/ASME Transactions on Mechatronics, vol. 20, no. 1, pp. 275–286, 2015.
[5] J. Zhang, G. Song, Y. Li, G. Qiao, and
Z. Li, “Battery swapping and wireless charging for a home robot system with remote human assistance,” IEEE Transactions on Consumer Electronics, vol. 59, no. 4, pp. 747–755, 2013.
[6] P. A. Plonski, J. V. Hook, and V. Isler, “Environment and solar map construction for solar-powered mobile systems,” IEEE Transactions on Robotics, vol. 32, no. 1, pp. 70–82, 2016.
[7] A. Kaplan, | N. Kingry, | J. V. D. Top,
K. Patel, R. Dai, and D. Grymin, “Motion planning for persistent traveling solar-powered unmanned ground vehicles,” in 2016 IEEE/RSJ International Conference on Intelligent Robots and Systems (IROS), Year in Conference, Conference Proceedings, pp. 3212–3218.

2
