amjadmajid/ipRobot/Latex/Thesis/pics/TU_border_A4_L_front-eps-converted-to.pdf

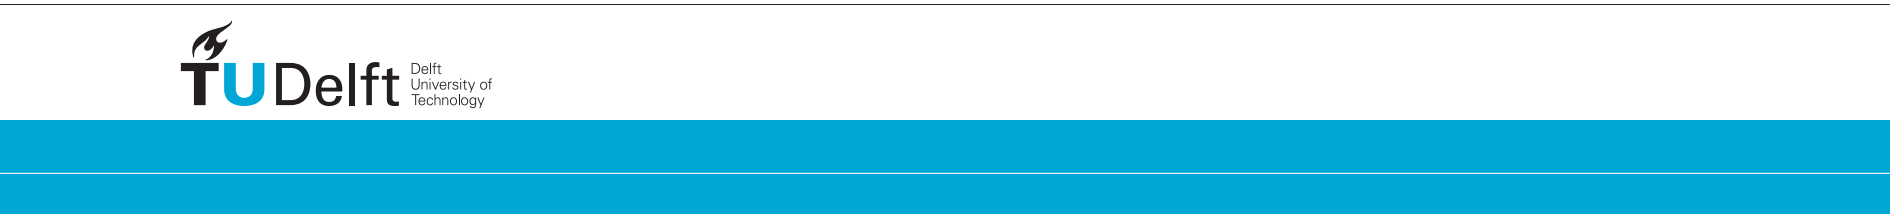
[picture p35: page 1]
