amjadmajid/ipRobot/Latex/Thesis/pics/es_logo_cyan_black_rgb-eps-converted-to.pdf

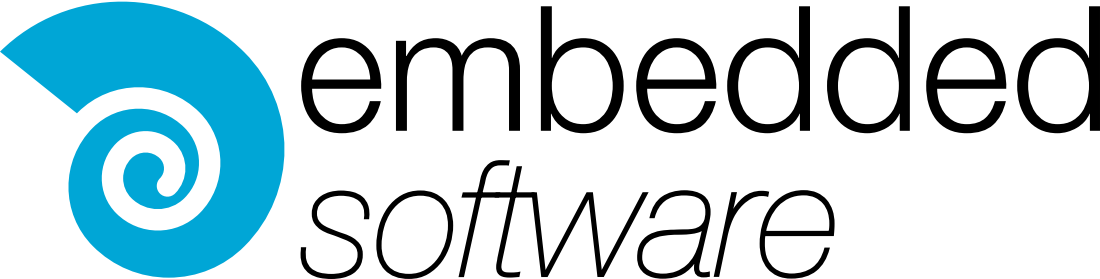
[picture p36: page 1]
