amjadmajid/ipRobot/Latex/Thesis/pics/TUD_logo_zw-eps-converted-to.pdf

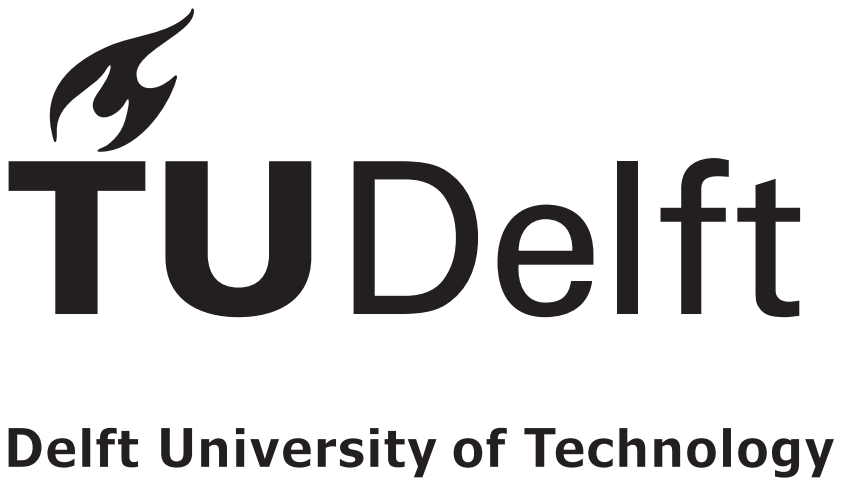
[picture p37: page 1]
