amjadmajid/ipRobot/PCB/Wisp5_Harvester_Motor-driver_V2/Wisp5_Harvester_Motor-driver_V2.brd

## EAGLE design PCB/Wisp5_Harvester_Motor-driver_V2/Wisp5_Harvester_Motor-driver_V2.brd (2017-10-15)

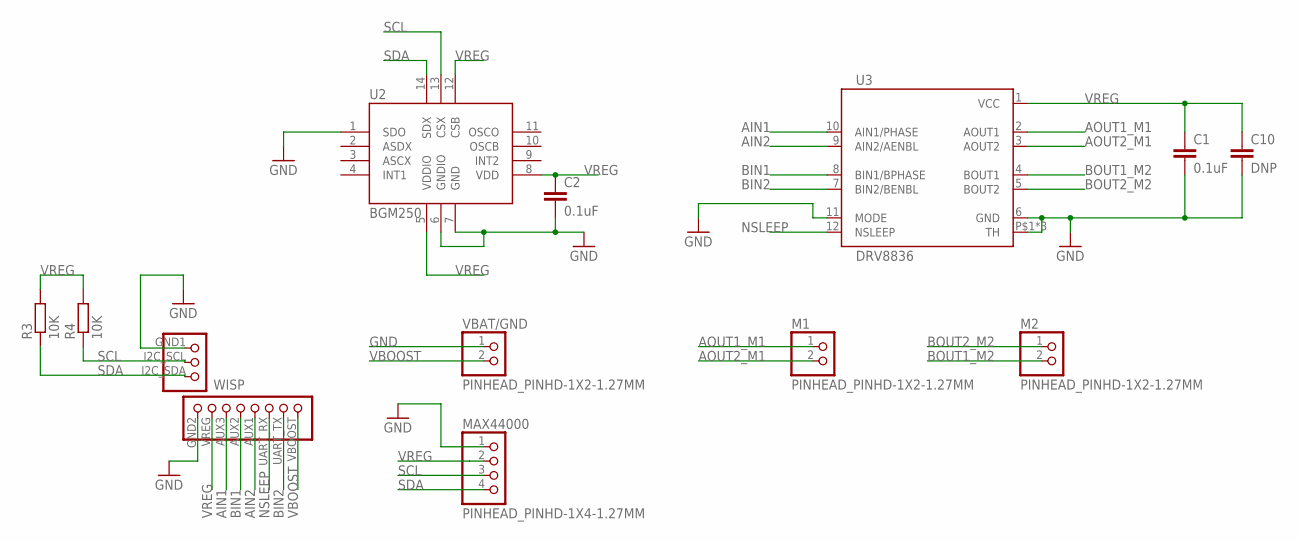
[picture p38: schematic Wisp5_Harvester_Motor-driver_V2.sch, sheet 1]

Parts:
C1, C2: 0.1uF; C0805
C10: DNP; C0805
M1, M2: PINHEAD_PINHD-1X2-1.27MM; PINHEAD_1X02-1.27MM
MAX44000: PINHEAD_PINHD-1X4-1.27MM; PINHEAD_1X04-1.27MM
R3, R4: 10K; R0805
U2: BGM250; LGA14L
U3: DRV8836; 12WSON
VBAT/GND: PINHEAD_PINHD-1X2-1.27MM; PINHEAD_1X02-1.27MM
WISP: WISP_HEADER; PINHEAD_WISP3X8-1.27MM

Connections:
AIN1: U3.10 (AIN1/PHASE), WISP.AUX3
AIN2: U3.9 (AIN2/AENBL), WISP.AUX1
AOUT1_M1: M1.1, U3.2 (AOUT1)
AOUT2_M1: M1.2, U3.3 (AOUT2)
BIN1: U3.8 (BIN1/BPHASE), WISP.AUX2
BIN2: U3.7 (BIN2/BENBL), WISP.UART_TX
BOUT1_M2: M2.2, U3.4 (BOUT1)
BOUT2_M2: M2.1, U3.5 (BOUT2)
GND: C1.2, C2.2, C10.2, MAX44000.1, U2.1 (SDO), U2.6 (GNDIO), U2.7 (GND), U3.6 (GND), U3.11 (MODE), U3.P$1 (TH), U3.P$2 (TH), U3.TH, VBAT/GND.1, WISP.GND1, WISP.GND2; also elsewhere on the board
NSLEEP: U3.12 (NSLEEP), WISP.UART_RX
SCL: MAX44000.3, R4.1, U2.13 (CSX), WISP.I2C_SCL
SDA: MAX44000.4, R3.1, U2.14 (SDX), WISP.I2C_SDA
VBOOST: VBAT/GND.2, WISP.VBOOST
VREG: C1.1, C2.1, C10.1, MAX44000.2, R3.2, R4.2, U2.5 (VDDIO), U2.8 (VDD), U2.12 (CSB), U3.1 (VCC), WISP.VREG; also elsewhere on the board

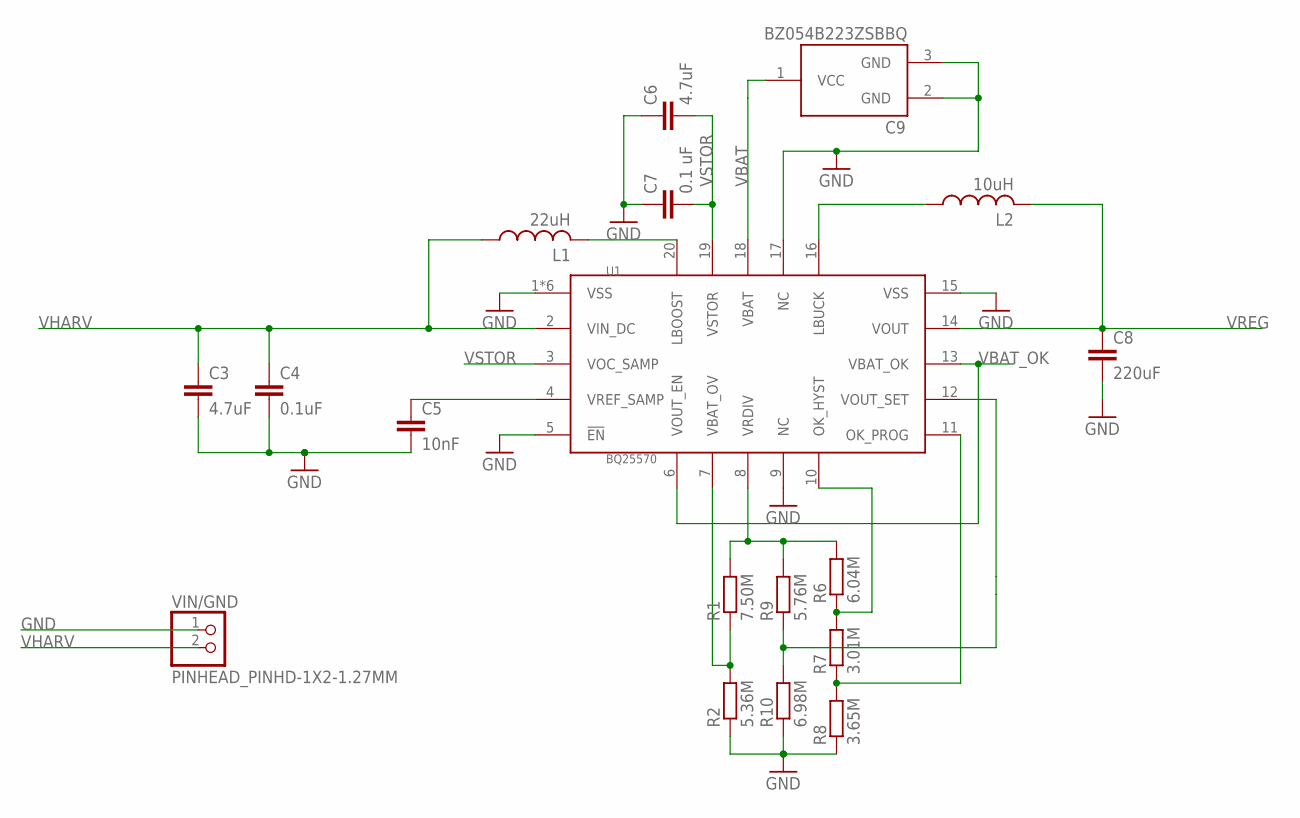
[picture p39: schematic Wisp5_Harvester_Motor-driver_V2.sch, sheet 2]

Parts:
C3, C6: 4.7uF; C0805
C4: 0.1uF; C0805
C5: 10nF; C0805
C7: 0.1 uF; C0805
C8: 220uF; C1210
C9: BZ054B223ZSBBQ; BZ05_S-STYLE
L1: 22uH; LPS4018
L2: 10uH; LPS4018
R1: 7.50M; R0805
R2: 5.36M; R0805
R6: 6.04M; R0805
R7: 3.01M; R0805
R8: 3.65M; R0805
R9: 5.76M; R0805
R10: 6.98M; R0805
U1: BQ25570; VQFN20
VIN/GND: PINHEAD_PINHD-1X2-1.27MM; PINHEAD_1X02-1.27MM

Connections:
GND: C3.2, C4.2, C5.2, C6.1, C7.1, C8.2, C9.2 (GND), C9.3 (GND), R2.1, R8.1, R10.1, U1.1 (VSS), U1.5 (!EN), U1.9 (NC), U1.15 (VSS), U1.17 (NC), U1.PWR_PAD (VSS), U1.PWR_PAD1 (VSS), U1.PWR_PAD2 (VSS), U1.PWR_PAD3 (VSS), U1.PWR_PAD4 (VSS), VIN/GND.1; also elsewhere on the board
unnamed: R9.1, R10.2, U1.12 (VOUT_SET)
unnamed: R1.2, R6.2, R9.2, U1.8 (VRDIV)
unnamed: L1.2, U1.20 (LBOOST)
unnamed: C5.1, U1.4 (VREF_SAMP)
unnamed: R6.1, R7.2, U1.10 (OK_HYST)
unnamed: L2.1, U1.16 (LBUCK)
unnamed: R1.1, R2.2, U1.7 (VBAT_OV)
unnamed: R7.1, R8.2, U1.11 (OK_PROG)
VBAT: C9.1 (VCC), U1.18 (VBAT)
VBAT_OK: U1.6 (VOUT_EN), U1.13 (VBAT_OK)
VHARV: C3.1, C4.1, L1.1, U1.2 (VIN_DC), VIN/GND.2
VREG: C8.1, L2.2, U1.14 (VOUT); also elsewhere on the board
VSTOR: C6.2, C7.2, U1.3 (VOC_SAMP), U1.19 (VSTOR)

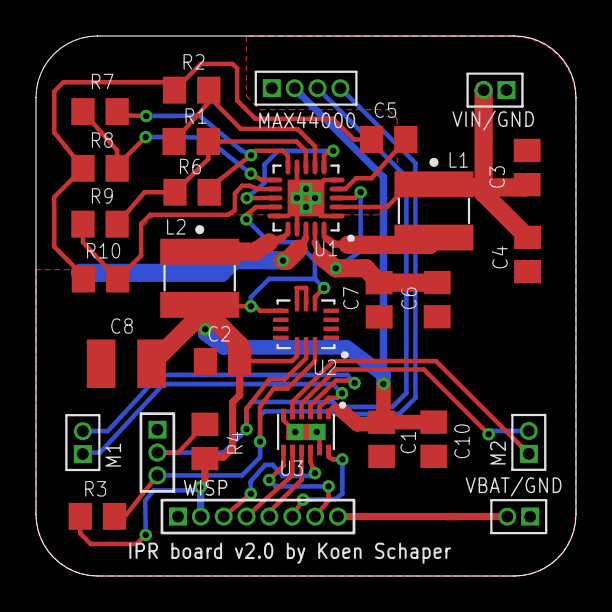
[picture p40: board Wisp5_Harvester_Motor-driver_V2.brd from above]

Board: 2 copper layers, 30.0 x 30.0 mm, 30 parts (1 on the bottom side), 26 nets.
