amjadmajid/ipRobot/PCB/Prox_board/prox_board_rotate.brd

## EAGLE design PCB/Prox_board/prox_board_rotate.brd (2017-08-08)

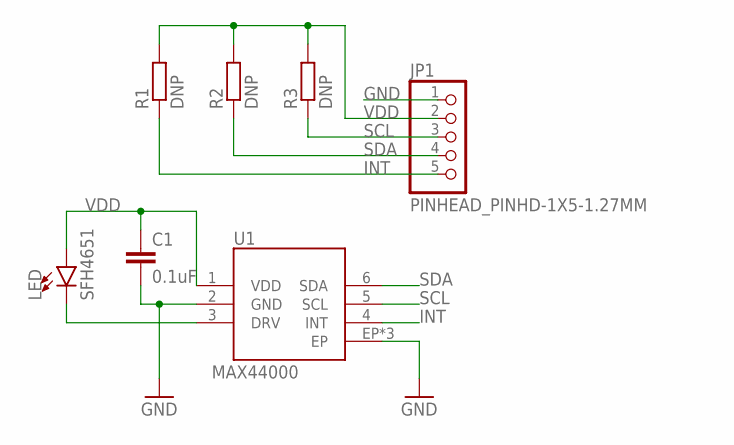
[picture p41: schematic prox_board_rotate.sch]

Parts:
C1: 0.1uF; C0603
JP1: PINHEAD_PINHD-1X5-1.27MM; PINHEAD_1X05-1.27MM
LED: SFH4651; MIDLED
R1, R2, R3: DNP; R0603
U1: MAX44000; 6OTDFN-EP

Connections:
GND: C1.2, JP1.1, U1.2 (GND), U1.EP, U1.P$1 (EP), U1.P$2 (EP)
INT: JP1.5, R1.1, U1.4 (INT)
unnamed: LED.C, U1.3 (DRV)
SCL: JP1.3, R3.1, U1.5 (SCL)
SDA: JP1.4, R2.1, U1.6 (SDA)
VDD: C1.1, JP1.2, LED.A, R1.2, R2.2, R3.2, U1.1 (VDD)

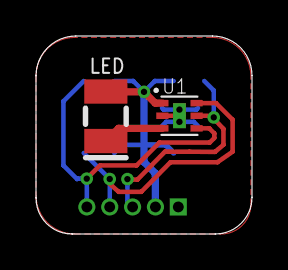
[picture p42: board prox_board_rotate.brd from above]

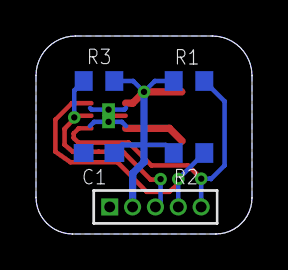
[picture p43: board prox_board_rotate.brd from below]

Board: 2 copper layers, 12.0 x 11.0 mm, 7 parts (5 on the bottom side), 6 nets.
