amjadmajid/ipRobot/PCB/Gyro_board/gyro_board.brd

## EAGLE design PCB/Gyro_board/gyro_board.brd (2017-08-07)

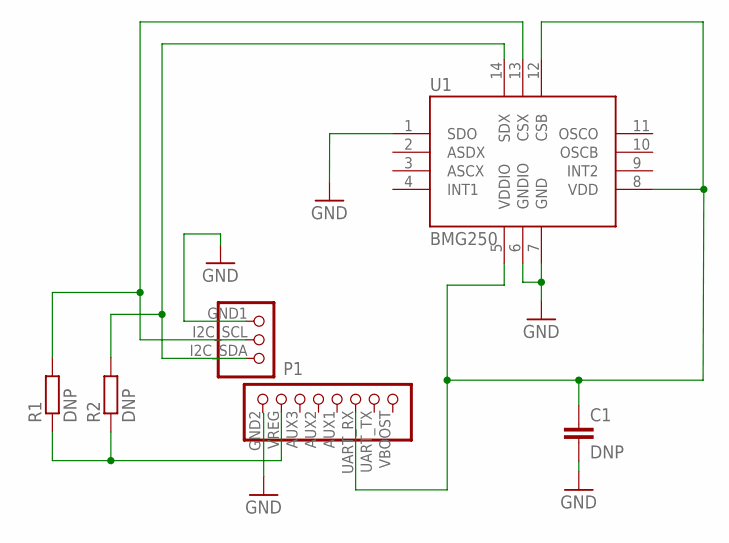
[picture p44: schematic gyro_board.sch]

Parts:
C1: DNP; C0603
P1: WISP_HEADER; PINHEAD_WISP3X8-1.27MM
R1, R2: DNP; R0603
U1: BMG250; LGA14L

Connections:
GND: C1.2, P1.GND1, P1.GND2, U1.1 (SDO), U1.6 (GNDIO), U1.7 (GND)
SCL: P1.I2C_SCL, R1.2, U1.13 (CSX)
SDA: P1.I2C_SDA, R2.2, U1.14 (SDX)
VEN: C1.1, P1.UART_RX, U1.5 (VDDIO), U1.8 (VDD), U1.12 (CSB)
VREG: P1.VREG, R1.1, R2.1

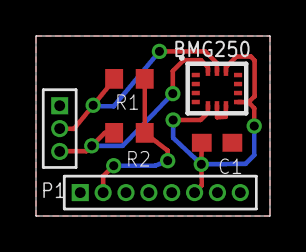
[picture p45: board gyro_board.brd from above]

Board: 2 copper layers, 13.0 x 10.0 mm, 5 parts (0 on the bottom side), 5 nets.
