amjadmajid/ipRobot/Code/DC_Intermittent_robot/ctrl_loop.h

/*
 * ctrl_loop.h
 *
 *  Created on: 8 aug. 2017
 *      Author: Koen Schaper
 */

#ifndef CTRL_LOOP_H_
#define CTRL_LOOP_H_

#include "motor_ctrl.h"

#define SAMPLE_TIME 0.01 // 100Hz

#define STRAIGHT    0x01
#define CURVE_LEFT  0x02
#define CURVE_RIGHT 0x03
#define TURN_LEFT   0x04
#define TURN_RIGHT  0x05

// Speed / Distance tuning parameters
#define MOT_TRG 40
#define VEL_CAL 24.3
#define R_CRV 30.0

#define TOLERANCE_DEGREES 2.0

typedef struct pid_tun{
    float Kp;
    float Ki;
    float Kd;
}pid_tun;

typedef struct robot_conf{
    pid_tun st;
    pid_tun tl;
    pid_tun tr;
    motor_calib mc;
}robot_conf;

extern nv_var fram;
extern nv_var fram_wc;

void ctrl_init();
void move(uint8_t cmd, int16_t arg);

#endif /* CTRL_LOOP_H_ */
