amjadmajid/ipRobot/Code/DC_Intermittent_robot/bor_timer.h

/*
 * bor_timer.h
 *
 *  Created on: 4 okt. 2017
 *      Author: Koen Schaper
 */

#ifndef BOR_TIMER_H_
#define BOR_TIMER_H_

void start_bor_timer(uint16_t time_ms);
void stop_bor_timer();

#endif /* BOR_TIMER_H_ */
