amjadmajid/ipRobot/(commit log)

2016-12-23 initial Motor driver
2016-12-25 Implementation of i2c expander motor driver
2016-12-28 Enable led during transmit
2016-12-28 Fix states which now include the sleep pin for both sides
    [main.c]
2016-12-28 Make sure interrupts are disabled, use or instead of sum and the small delay fixes hang
    [main.c]
2017-01-05 Initial schematic and board files for first prototype
    [Wisp5_Harvester_Motor-driver.brd, Wisp5_Harvester_Motor-driver.sch]
2017-01-06 Redone previous work, with more focus on power routing.
    [Wisp5_Harvester_Motor-driver.brd, Wisp5_Harvester_Motor-driver.sch]
2017-01-06 Added boardversion and fixed header spacing for wisp5
    [Wisp5_Harvester_Motor-driver.brd]
2017-01-07 Changed capacitor naming, relocated part values and removed default dimension layer
    [Wisp5_Harvester_Motor-driver.brd, Wisp5_Harvester_Motor-driver.sch]
2017-01-07 Tent vias smaller than 20mil
    [Wisp5_Harvester_Motor-driver.brd]
2017-01-07 Ordered this board!
    [Wisp5_Harvester_Motor-driver.brd]
2017-01-09 Updated resistor values: VBAT_OV, VBAT_OK, VBAT_OK_HYST and VOUT
    [Wisp5_Harvester_Motor-driver.brd, Wisp5_Harvester_Motor-driver.sch, bq25570_Resistor_values.xlsx]
2017-01-10 Increase all decoupling capacitors from 0.01uF to 0.1uF, according to the reference design of the harvester and motor driver
    [Wisp5_Harvester_Motor-driver.brd, Wisp5_Harvester_Motor-driver.sch]
2017-01-12 Text code for driving the motors with the new pcb, which uses a 8bit instead of io expander
2017-01-16 Separate files for i2c and use a struct to store variables in fram
2017-01-19 Remove delay from transmit function and only use it when required Fixed wrong values for B phase in state array
    [eusci_b0_i2c.c, main.c]
2017-01-20 Separate function for driving the motors. First perpare a array with instructions, then drive the motors.
2017-01-20 Added a separate function for initializing the motor driver
2017-01-20 Added a function to drive motors for x numer of steps given a directonal command
2017-01-23 Created separte files for motor control
2017-01-25 Changed the address and cmds according to TCA9538 (used on PCB)
2017-01-30 Disable led and increase duty cycle because more torque is required
2017-02-13 Removed duty cycle from motors and just set delay instead of calculating it..
2017-02-16 Use working copy + pointer swap to make sure the motor state is consistent
    [global.h, main.c, motor_ctrl.c, motor_ctrl.h]
2017-03-06 Add delay after disabling and set debug voltage to 2200 mV
2017-03-08 Added a button press wait to be able to do test over and over again. Slowed down motor speed for the bigger wheels
2017-03-13 Make the slave address configurable and added a i2c read function for reading a single byte!
2017-03-13 Update motor_ctrl with new i2c functions and moved enable pin configuration to drv_init() !
2017-03-13 Basic proximity sensor code, still requires testing!
2017-03-20 Working i2c without delay!
2017-03-20 Revert delay, minus 800 not required anymore
    [motor_ctrl.h]
2017-03-23 Commit progress, although proximity sensing is not working
    [eusci_b0_i2c.c, eusci_b0_i2c.h, prox_sens.c, prox_sens.h]
2017-03-24 Proximity is working now! The current limiting resistor on the evaluation board was the problem! Decrease light sensitivity and include header file in main
    [main.c, prox_sens.c]
2017-03-24 Initialize i2c only once!
2017-04-10 Added more references and part about supercap vs battery
2017-04-11 init i2c in main!
2017-04-12 gyro and proximity parts library
2017-04-18 Added the wisp Gyro board!
    [gyro_board.brd, gyro_board.sch]
2017-04-18 Fix component name typo
    [gyro_board.brd, gyro_board.sch]
2017-05-01 Save current gyro library progress!
2017-05-03 Gyro initialization seems to work, need a lot of data!
2017-05-03 Solved issue, send stop before RXIFG and use normal int because angular velocity can be +/-
    [eusci_b0_i2c.c, gyro_sens.c, gyro_sens.h]
2017-05-04 The main clock was actually running 4Mhz instead of 8Mhz, now fixed
    [main.c, motor_ctrl.h]
2017-06-06 Upload proximity board schematic
    [prox_board.sch]
2017-06-07 Commit current progress
2017-07-05 Abstract steppermotor control
2017-07-11 Upload DC intermittently powered robot files
2017-07-12 Simple example to drive the dc motor.
2017-07-12 Increase i2c clk to 400khz
2017-07-13 Pwm control of the motor + method to disable the timer
2017-07-16 Ramp pwm to decrease startup current when driving two motors!
2017-07-16 Only enable motordriver 1 and only enable one of the motors
2017-07-24 Fix commit c099b76 !
    [main.c]
2017-07-24 Working example pwm for both motors -> going kind of straight!
2017-07-24 Removed parts about the stepper motors, localization and locomotion
2017-07-24 Add gyroscope files
2017-07-24 Only return the z-axis gyroscope data
2017-07-24 Also fix gyroscope for DC project
    [gyro_sens.c]
2017-07-24 Timer based checkpointing!
2017-07-27 Save progress robot pcb design v2
    [Wisp5_Harvester_Motor-driver_V2.sch]
2017-07-28 Added proximity header and fixed layout
    [Wisp5_Harvester_Motor-driver_V2.sch]
2017-07-28 Added 1D printing reference
2017-07-31 Update schematic
    [Wisp5_Harvester_Motor-driver_V2.sch]
2017-07-31 Updated packages
    [Wisp5_Harvester_Motor-driver_V2.sch]
2017-07-31 Change bulk capacitor from 805 to 1210
    [Wisp5_Harvester_Motor-driver_V2.sch]
2017-07-31 Removed some small separate packages
    [Wisp5_Harvester_Motor-driver_V2.sch]
2017-08-01 Working example of using timer B0 to drive forward and backward!
2017-08-01 Changed output pins so they work with wisp timer directly and also changed M2 (right) ground and power order
    [Wisp5_Harvester_Motor-driver_V2.sch]
2017-08-01 Read gyro and added python file from other dc_motor_direct_h branch
2017-08-01 Update schematic, added missing scl and sda lines for the gyro
    [Wisp5_Harvester_Motor-driver_V2.sch]
2017-08-02 Upload board without routing and the library for the parts!
    [Wisp5_Harvester_Motor-driver_V2.brd]
2017-08-02 Routing WIP
    [Wisp5_Harvester_Motor-driver_V2.brd]
2017-08-02 Go straight for different speeds upto 40% pwm!
2017-08-03 Increased sample frequency to 400Hz and now using a PD controller
2017-08-03 Working PD values and some small fixes
    [gyro_sens.c, main.c]
2017-08-04 Increased Kp and Kd using the following steps (recommended answer): https://robotics.stackexchange.com/questions/167/what-are-good-strategies-for-tuning-pid-loops
2017-08-05 Finished routing + fixed drv8836
    [Wisp5_Harvester_Motor-driver_V2.brd, Wisp5_Harvester_Motor-driver_V2.sch]
2017-08-05 Tend vias and added stop to powerpad vias!
    [Wisp5_Harvester_Motor-driver_V2.brd, Wisp5_Harvester_Motor-driver_V2.sch]
2017-08-05 Fix the naming on the pcb and of the parts!
    [Wisp5_Harvester_Motor-driver_V2.brd, Wisp5_Harvester_Motor-driver_V2.sch]
2017-08-06 Created board file for proximity
    [prox_board.brd, prox_board.sch]
2017-08-06 Rotated header, to make it fit the mainboard!
    [prox_board_rotate.brd, prox_board_rotate.sch]
2017-08-06 Fix naming and silkscreen on the back of the board!
    [prox_board_rotate.brd, prox_board_rotate.sch]
2017-08-06 Added powering pervasive computing systems reference!
2017-08-07 Add a exta bulk capacitor near the hbridge!
    [Wisp5_Harvester_Motor-driver_V2.brd, Wisp5_Harvester_Motor-driver_V2.sch]
2017-08-07 Remove old stepper text
2017-08-08 Small changes to the layout and added missing inductor values!
    [Wisp5_Harvester_Motor-driver_V2.brd, Wisp5_Harvester_Motor-driver_V2.sch]
2017-08-08 Non power return paths!
    [Wisp5_Harvester_Motor-driver_V2.brd]
2017-08-08 Final design for proximity and harvester board
    [Wisp5_Harvester_Motor-driver_V2.brd, prox_board_rotate.brd]
2017-08-08 Update motor_ctrl
2017-09-04 Use a timer for the loop and removed the data ready check from the gyro because it slows down the loop significantly!
2017-09-06 Change sample / loop frequency to 50Hz and implemented a PI controller
2017-09-06 Save error instead of omega and use defines for the constants. Pid loop is working but
    [ctrl_loop.c]
2017-09-07 Separate function for computing the pid: http://brettbeauregard.com/blog/2011/04/improving-the-beginner%E2%80%99s-pid-sample-time/
2017-09-07 changing both left and right speeds seems to work good, but needs to be tested with the other motors
2017-09-10 Only one function for driving the motors, forward, reverse and stop! (Other files still need to be updated!)
    [motor_ctrl.c, motor_ctrl.h]
2017-09-12 Fix sign (left and right motor ctrl) and cleanup
    [ctrl_loop.c, ctrl_loop.h, global.h]
2017-09-13 Use single define for the sample time!
2017-09-14 Limit motor setpoint inside drv_mot()
2017-09-18 Persistent movement, currently only works for battery powered, probably due to exceeding max speed (solar powered)!
2017-09-18 Reduce target speed, so that solar powerd also works. Bound motor setpoint to max 120!
2017-09-20 Fix inductor naming! switched them around...
    [Wisp5_Harvester_Motor-driver_V2.brd]
2017-09-21 Invert motor orientation so it corresponds to the new pcb!
    [ctrl_loop.c, motor_ctrl.c]
2017-09-21 Fix battery header orientation!
    [Wisp5_Harvester_Motor-driver_V2.brd]
2017-09-22 Increase gyroscope resolution!
2017-09-23 Revert "Invert motor orientation so it corresponds to the new pcb!"
    This reverts commit 25458353622f66f5e7fd83711e1725967b6ee760.
    [ctrl_loop.c, motor_ctrl.c]
2017-09-23 Fix left and right + new minimal calibration values!
    [motor_ctrl.c, motor_ctrl.h]
2017-09-24 Fixed turning, use just a simple p controller and increased sample frequency to 100Hz
    [ctrl_loop.c, ctrl_loop.h, gyro_sens.c, motor_ctrl.c]
2017-09-26 Reset values to zero on disabling the loop and include angle in command loop
    [ctrl_loop.c, ctrl_loop.h, main.c]
2017-09-27 Update PID text
2017-09-27 Reduce i2c frequency to 100kHz and use the submainclock for the control loop timer as well using a divider
2017-09-27 Include proximity sensor
2017-09-27 Revert "Reduce i2c frequency to 100kHz and use the submainclock for the control loop timer as well using a divider"
    This reverts commit 95ce77952955aadde1d43b72cb564cbdfe4c6ff5.
    [ctrl_loop.c, eusci_b0_i2c.c, main.c]
2017-09-28 Save new calibration values for turning!
2017-09-28 Make motor stop more imidiate!
2017-09-28 read_gyro.py is now also used to plot the figures for tuning the controllers
    [straight_kp010_osc_200.csv, straight_kp012_osc_200.csv, straight_kp013_osc_200.csv, straight_kp013_tu20_200.csv, straight_kp014_osc_200.csv, turn_left_p075.csv, turn_right_p035.csv]
2017-09-28 Save progress on pid tuning!
2017-09-29 Cleanup and consistency fix
    [ctrl_loop.c, global.h, main.c]
2017-10-05 Remove global.c and change the control loop timer fram A2 to A3
2017-10-05 Added a power interrupt timer that creates a brownout interrupt after a certain time
    [bor_timer.c, bor_timer.h, ctrl_loop.h, global.h, main.c]
2017-10-06 Move delay right after init and before the gyroscope is initialized
2017-10-06 Upload Python files
    [half_freq_185.csv, max_freq.csv, max_freq2_140.csv, max_freq3_150.csv, max_freq4_160.csv, max_freq5_170.csv, max_freq_370.csv, min_freq.csv]
2017-10-10 Save solar powered measurement!
2017-10-11 Save light experiment
    [Light_experiment_11-10.xlsx]
2017-10-11 Save data
    [Light_experiment_11-10.xlsx]
2017-10-11 Done with solar light experiment!
    [Light_experiment_11-10.xlsx]
2017-10-12 Save experiment data and python plot
    [Light_experiment_11-10.xlsx]
2017-10-12 Save min speed experiment data (half way)
    [Min_speed_experiment_12-10.xlsx]
2017-10-12 Save minimum speed experiment data
    [Min_speed_experiment_12-10.xlsx]
2017-10-13 Renamed plot and added cost of parts
    [cost_of_parts.xlsx]
2017-10-13 Updated cost_of_parts.xlsx
    [cost_of_parts.xlsx]
2017-10-15 Update pcb header drill size
    [Wisp5_Harvester_Motor-driver_V2.brd, Wisp5_Harvester_Motor-driver_V2.sch]
2017-10-16 Upload motor frame and added 20 sec speed calibration@ 40 target
    [Min_speed_experiment_12-10.xlsx, Robot_v2.0_frame.scad]
2017-10-16 Update light experiment data from digikey panel (in parallel now)
    [Light_experiment_11-10.xlsx]
2017-10-16 Update light experiment data
    [Light_experiment_11-10.xlsx]
2017-10-16 Struct for setting the motor values instead of defines!
2017-10-17 Save robot tuning data
    [r2_straight_kp0.10_osc_200.csv, r2_straight_kp0.12_osc_200.csv, r2_straight_kp0.14_osc_200.csv, r2_straight_kp0.16_osc_200.csv, r2_straight_kp0.18_osc_200.csv, r2_straight_kp0.18_osc_v2_200.csv, r2_straight_kp0.18_tu20_200.csv, r2_straight_kp0.19_osc_200.csv]
2017-10-19 Upload experiment data
    [half_freq_185.csv, max_freq_370.csv, min_freq.csv, r1_max_freq_1.csv, r1_max_freq_100.csv, r1_max_freq_10step_ramp_to_80.csv, r1_max_freq_19step_ramp_to_76.csv, r1_max_freq_1_V2.csv]
2017-10-19 Upload missing experiment data
    [Min_speed_experiment_12-10.xlsx, half_freq_185.csv, max_freq_370.csv, min_freq.csv]
2017-10-20 Update experiment data
    [half_freq_185.csv, max_freq_370.csv, min_freq.csv, r1_max_freq_1.csv, r1_max_freq_10step_ramp_to_100.csv, r1_max_freq_10step_ramp_to_120.csv, r1_max_freq_10step_ramp_to_140.csv, r1_max_freq_120.csv]
2017-10-23 Update experiment data!
    [r1_gyro_20step_100_trg.csv, r1_gyro_no_ramp_100_trg.csv, r1_max_freq_10step_ramp_to_100_v2.csv, r2_max_freq_100.csv, r2_max_freq_10step_ramp_to_100.csv, r2_max_freq_10step_ramp_to_120.csv, r2_max_freq_10step_ramp_to_140.csv, r2_max_freq_10step_ramp_to_80.csv]
2017-10-24 Save updated current consumed table!
2017-10-24 Save energy measurment data
    [R1_Wisp_Enable_8Mhz_and_gyro_and_hbridge_to_LED.csv, R1_Wisp_Enable_8Mhz_and_gyro_to_LED.csv, R1_Wisp_Enable_8Mhz_and_hbridge_to_LED.csv, R1_Wisp_Enable_8Mhz_and_proximity_to_LED.csv, R1_Wisp_Enable_8Mhz_to_LED.csv, Wisp_Enable_8Mhz_to_LED.csv]
2017-10-27 Disable motors at zero setpoint!
2017-10-27 Fixed curved movements with intermittency!
    [ctrl_loop.c]
2017-10-30 Fix right and left turning!
    [ctrl_loop.c]
2017-10-30 Save turn calibrated values!
2017-11-02 Created a preliminaries chapter and started on the stepper motor section
2017-11-02 Update stepper motor text
2017-11-03 Added reference to the monsoon powermonitor
2017-11-06 Update table with cost in euro
    [cost_of_parts.xlsx]
2017-11-07 Mearsure led power consumption as well
    [Wisp_Enable_8Mhz_to_Enable_green_LED(wisp5.0).csv, Wisp_Enable_8Mhz_to_Enable_red_LED(wisp5.1).csv]
2017-11-08 Update cost and robot comparison table
    [cost_of_parts.xlsx]
2017-11-08 Update Robot table
    [cost_of_parts.xlsx]
2017-11-09 Upload speed / pwm relation data!
    [PWM_SPEED_RELATION.xlsx]
2017-11-09 Update table to find speed
    [PWM_SPEED_RELATION.xlsx]
2017-11-10 Update robot tracking to count the numer of frames and set the buffer + only show the last frame!
2017-11-10 Upload pwm_speed experiments
    [PWM_SPEED_RELATION.xlsx]
2017-11-11 Upload circle pwm 70 data
    [Video_trg_70_r1_right_r30_battery_1.csv, Video_trg_70_r1_right_r30_battery_2.csv, Video_trg_70_r1_right_r30_battery_3.csv, Video_trg_70_r1_right_r30_battery_int1000_1.csv, Video_trg_70_r1_right_r30_battery_int1000_2.csv, Video_trg_70_r1_right_r30_battery_int1250_1.csv, Video_trg_70_r1_right_r30_battery_int1250_2.csv, Video_trg_70_r1_right_r30_battery_int500_1.csv]
2017-11-11 Upload circle pwm 50 data
    [Video_trg_50_r1_50_right_battery_int750_1.csv, Video_trg_50_r1_50_right_battery_int750_2.csv, Video_trg_50_r1_right_r30_battery_1.csv, Video_trg_50_r1_right_r30_battery_2.csv, Video_trg_50_r1_right_r30_battery_3.csv, Video_trg_50_r1_right_r30_battery_int1000_1.csv, Video_trg_50_r1_right_r30_battery_int1000_2.csv, Video_trg_50_r1_right_r30_battery_int1250_1.csv]
2017-11-11 Upload square pwm 70 data
    [Video_trg_70_r1_right_battery_1.csv, Video_trg_70_r1_right_battery_2.csv, Video_trg_70_r1_right_battery_3.csv, Video_trg_70_r1_right_battery_int1000_1.csv, Video_trg_70_r1_right_battery_int1000_2.csv, Video_trg_70_r1_right_battery_int1250_1.csv, Video_trg_70_r1_right_battery_int1250_2.csv, Video_trg_70_r1_right_battery_int500_1.csv]
2017-11-11 Upload square pwm 50 data
    [Video_trg_50_r1_50_right_battery_1.csv, Video_trg_50_r1_50_right_battery_2.csv, Video_trg_50_r1_50_right_battery_3.csv, Video_trg_50_r1_50_right_battery_int1000_1.csv, Video_trg_50_r1_50_right_battery_int1000_2.csv, Video_trg_50_r1_50_right_battery_int1250_1.csv, Video_trg_50_r1_50_right_battery_int1250_2.csv, Video_trg_50_r1_50_right_battery_int500_1.csv]
2017-11-11 Upload square pwm 30 data
    [Video_trg_30_r1_50_right_battery_1.csv, Video_trg_30_r1_50_right_battery_2.csv, Video_trg_30_r1_50_right_battery_3.csv, Video_trg_30_r1_50_right_battery_int1000_1.csv, Video_trg_30_r1_50_right_battery_int1000_2.csv, Video_trg_30_r1_50_right_battery_int1250_1.csv, Video_trg_30_r1_50_right_battery_int1250_2.csv, Video_trg_30_r1_50_right_battery_int500_1.csv]
2017-11-11 Upload straight pwm 70 data
    [Video_trg_70_r1_75_battery_1.csv, Video_trg_70_r1_75_battery_2.csv, Video_trg_70_r1_75_battery_int1000_1.csv, Video_trg_70_r1_75_battery_int1000_2.csv, Video_trg_70_r1_75_battery_int1250_1.csv, Video_trg_70_r1_75_battery_int1250_2.csv, Video_trg_70_r1_75_battery_int500_1.csv, Video_trg_70_r1_75_battery_int500_2.csv]
2017-11-11 Upload straight 50 pwm data
    [Video_trg_50_r1_75_battery_1.csv, Video_trg_50_r1_75_battery_2.csv, Video_trg_50_r1_75_battery_3.csv, Video_trg_50_r1_75_battery_int1000_1.csv, Video_trg_50_r1_75_battery_int1000_2.csv, Video_trg_50_r1_75_battery_int1250_1.csv, Video_trg_50_r1_75_battery_int1250_2.csv, Video_trg_50_r1_75_battery_int500_1.csv]
2017-11-11 Upload straight pwm 30 data
    [Video_trg_30_r1_75_battery_1.csv, Video_trg_30_r1_75_battery_2.csv, Video_trg_30_r1_75_battery_3.csv, Video_trg_30_r1_75_battery_int1000_1.csv, Video_trg_30_r1_75_battery_int1000_2.csv, Video_trg_30_r1_75_battery_int1250_1.csv, Video_trg_30_r1_75_battery_int1250_2.csv, Video_trg_30_r1_75_battery_int500_1.csv]
2017-11-12 Cleanup data
    [Video_trg_30_r1_50_right_battery_1.csv, Video_trg_30_r1_50_right_battery_2.csv, Video_trg_30_r1_50_right_battery_3.csv, Video_trg_30_r1_50_right_battery_int1000_1.csv, Video_trg_30_r1_50_right_battery_int1000_2.csv, Video_trg_30_r1_50_right_battery_int1250_1.csv, Video_trg_30_r1_50_right_battery_int1250_2.csv, Video_trg_30_r1_50_right_battery_int500_1.csv]
2017-11-12 Fixed plotting for each of the three pwm speeds
2017-11-12 set pwm trough variable
2017-11-13 Make het different movements selectable!
2017-11-13 Fix plot
    [BAD_Video_trg_70_r1_75_battery_2.csv]
2017-11-14 Add temporary movement evaluation
    [BAD_Video_trg_50_r1_right_r30_battery_2.csv]
2017-11-14 Update stepper motor preliminaries
2017-11-18 Upload simulink cd motor model!
2017-11-18 Save python implementation of motor model!
2017-11-20 Working pwm function!
2017-11-20 Fix wheel diameter and output distance
2017-11-20 Upload current measurements for no pwm motors different robots
    [R1_left_no_pwm_current_2.2v.csv, R1_left_no_pwm_current_2.2v_no_wheel.csv, R1_left_no_pwm_current_2.2v_no_wheel_v2.csv, R1_left_no_pwm_current_2.2v_v2.csv, R1_right_no_pwm_current_2.2v.csv, R1_right_no_pwm_current_2.2v_no_wheel.csv, R2_left_no_pwm_current_2.2v.csv, R2_left_no_pwm_current_2.2v_no_wheel.csv]
2017-11-20 Added schematic to appendix
2017-11-21 Update transiently powered systems!
2017-11-22 Processed data for minimal interrupt time!
    [Video_trg_30_r1_battery_int200_1.csv, Video_trg_30_r1_battery_int200_2.csv, Video_trg_30_r1_battery_int300_1.csv, Video_trg_30_r1_battery_int300_2.csv, Video_trg_30_r1_battery_int400_1.csv, Video_trg_30_r1_battery_int400_2.csv, Video_trg_50_r1_battery_int200_1.csv, Video_trg_50_r1_battery_int200_2.csv]
2017-11-22 Fix artifacts and update plot movements
    [Video_trg_30_r1_battery_int200_1.csv, Video_trg_30_r1_battery_int200_2.csv, Video_trg_30_r1_battery_int300_1.csv, Video_trg_30_r1_battery_int300_2.csv, Video_trg_30_r1_battery_int400_1.csv, Video_trg_30_r1_battery_int400_2.csv, Video_trg_70_r1_battery_int300_1.csv, Video_trg_70_r1_battery_int300_2.csv]
2017-11-23 Add outside solar experiments
    [Light_experiment_11-10.xlsx, Light_experiment_11-10_and_23-11.xlsx]
2017-11-25 Use single plot function!
    [Light_experiment_11-10_and_23-11.xlsx]
2017-11-26 Update python and excel files!
    [Light_experiment_11-10_and_23-11.xlsx, RF_experiment_23-11.xlsx]
2017-11-27 Update experimental data stepper motor!
2017-11-27 Update figure, might need one with pwm?
2017-11-28 Update plotmovement!
    [settings_deviation_from_circle.xlsx]
2017-11-28 Update circle estimate
    [BAD_Video_trg_50_r1_right_r30_battery_2.csv, Video_trg_50_r1_right_r30_battery_1.csv, Video_trg_50_r1_right_r30_battery_2.csv, Video_trg_50_r1_right_r30_battery_3.csv, settings_deviation_from_circle.xlsx]
2017-11-28 Update Evaluation seciton
    [Video_trg_50_r1_right_r30_battery_1.csv]
2017-11-29 Update deviation from circle table, error in mean calulation!
    [settings_deviation_from_circle.xlsx]
2017-11-29 Update evaluation straight section
    [settings_deviation_from_straight.xlsx]
2017-11-29 Update files from solar experiments
    [PWM_SPEED_RELATION.xlsx, Video_circle_trg_50_r1_r30_solar_1.csv, Video_circle_trg_50_r1_r30_solar_2.csv, Video_circle_trg_50_r1_r30_solar_3.csv, Video_circle_trg_70_r1_r30_solar_1.csv, Video_circle_trg_70_r1_r30_solar_2.csv, Video_circle_trg_70_r1_r30_solar_3.csv]
2017-11-29 Update solar experiment data!
    [Video_circle_trg_30_r1_r30_solar_1.csv, Video_circle_trg_30_r1_r30_solar_2.csv, Video_circle_trg_30_r1_r30_solar_3.csv, Video_straight_trg_30_r1_75_solar_1.csv, Video_straight_trg_30_r1_75_solar_2.csv, Video_straight_trg_30_r1_75_solar_3.csv, Video_straight_trg_50_r1_75_solar_1.csv, Video_straight_trg_50_r1_75_solar_2.csv]
2017-11-30 Added solar experiment + max for circle
    [BAD_Video_circle_trg_50_r1_r30_solar_2.csv, Video_circle_trg_50_r1_r30_solar_2.csv, Video_circle_trg_50_r1_r30_solar_3.csv, settings_deviation_from_circle.xlsx, settings_deviation_from_straight.xlsx]
2017-11-30 Final values for length of movement
    [settings_deviation_from_straight.xlsx]
2017-12-04 Update evaluation and preliminaries!
    [Video_trg_30_r1_75_solar_1.csv, Video_trg_30_r1_75_solar_2.csv, Video_trg_30_r1_75_solar_3.csv, Video_trg_30_r1_right_r30_solar_1.csv, Video_trg_30_r1_right_r30_solar_2.csv, Video_trg_30_r1_right_r30_solar_3.csv, Video_trg_50_r1_75_solar_1.csv, Video_trg_50_r1_75_solar_2.csv]
2017-12-08 Update preliminaries
    [Light_experiment_11-10_and_23-11.xlsx]
2017-12-08 Update flowchart of code!
2017-12-10 Stage current measurements pwm 40%
    [R1_left_40%_pwm_current_2.2v_no_wheel.csv, R1_right_40%_pwm_current_2.2v_no_wheel.csv, R3_left_40%_pwm_current_2.2v_no_wheel.csv, R3_right_40%_pwm_current_2.2v_no_wheel.csv]
2017-12-10 Dash transiently-powered!
